Quang-VM/STM32-Based-Multisine-EIS-Platform/README.md

# STM32-Based Multisine EIS Platform for Equivalent Circuit Parameter Estimation
