Quang-VM/STM32-Based-Multisine-EIS-Platform/software_host/README.md

## Host software: 

Built with **Qt 6 / PyQt6** for realtime visualization, recording and replay of the impedance
spectra streamed by the STM32 device: Nyquist and Bode plots, live serial console, threaded serial reader,
CSV record / export / load. 

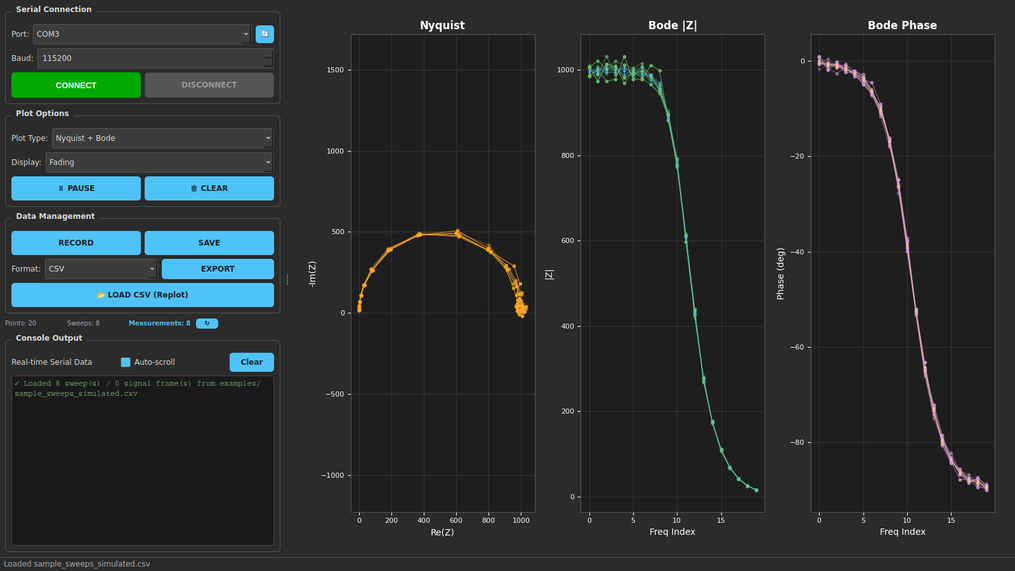
[picture p1: software_host/gui_screenshot.png]
Qt GUI
