Quang-VM/STM32-Based-Multisine-EIS-Platform/report/presentation.pdf

‹Nr.›/xx

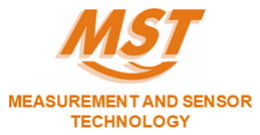
[picture p2: figure]
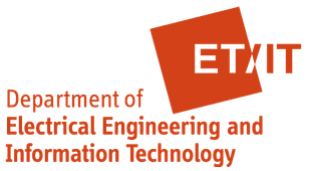
[picture p3: figure]
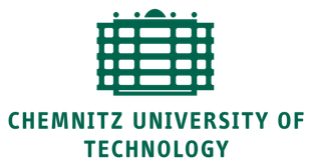
[picture p4: figure]

Group 01 <Please adapt this in the slide master>

## STM32-Based Multisine EIS Platform for Equivalent-Circuit Parameter Estimation

Tuan Minh Le
Khoi Nguyen Nguyen
Gia Khanh Nguyen
Minh Quang Vu

### „Project Lab Embedded Systems”

Chemnitz University of Technology, Chemnitz, 12th August 2026

1

Group 15 STM32-Based Multisine EIS Platform Chair of Measurement and Sensor Technology

# Overview

### Introduction

### System Architecture Overview

### Hardware and Software

### IS Measurement Results

### GUI & Dataset Pipeline

### Machine Learning Model Design

### Results and Evaluation

### Limitations & Conclusion

2

Group 15 STM32-Based Multisine EIS Platform

Member | Presentation
Gia Khanh Nguyen | Introduction System Architecture Overview Hardware and Software
Minh Quang Vu | IS Measurement Results
Khoi Nguyen Nguyen | GUI & Dataset Pipeline Machine Learning Model Design
Tuan Minh Le | Results and Evaluation Limitations & Conclusion

Chair of Measurement and Sensor Technology

# Member Responsibilities

3

Group 15 STM32-Based Multisine EIS Platform
Chair of Measurement and Sensor Technology | 4

# Introduction

THE PROBLEM
Expensive & bulky | Expert-driven fitting Interpreting a spectrum means offline curve- fitting to an equivalent circuit, supervised by a specialist.

Commercial impedance analyzers cost tens of
thousands of euros and require the DUT to be
brought into a lab.

Q1 — Measurement

How to acquire a fast, sufficiently accurate impedance spectrum using only peripherals already built into a general-purpose MCU?

Q2 — Inference

How to recover circuit topology and component values on-device, within a few tens of kB of RAM and a few ms of runtime?

2

"EIS: characterizing a material or device by measuring impedance across a frequency range"

TWO QUESTIONS TO ANSWER

# Overview of proposed Architecture

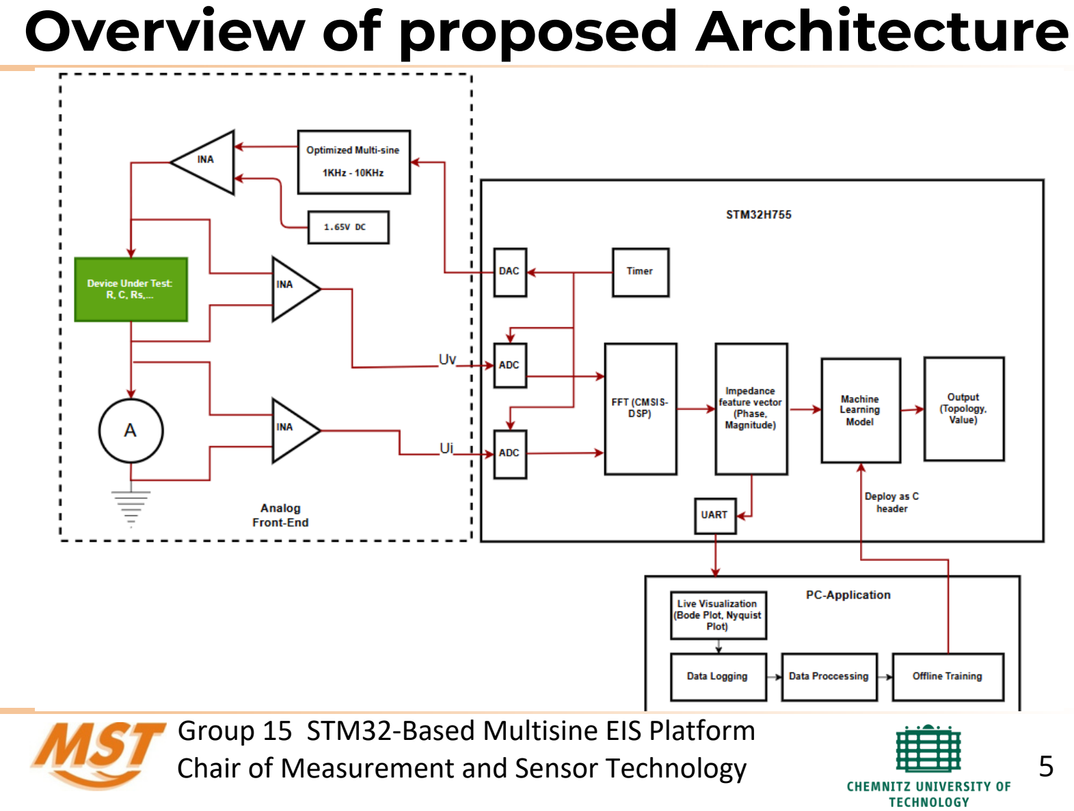
[picture p5: page 5]

Group 15 STM32-Based Multisine EIS Platform

# Hardware — Analog Front-End

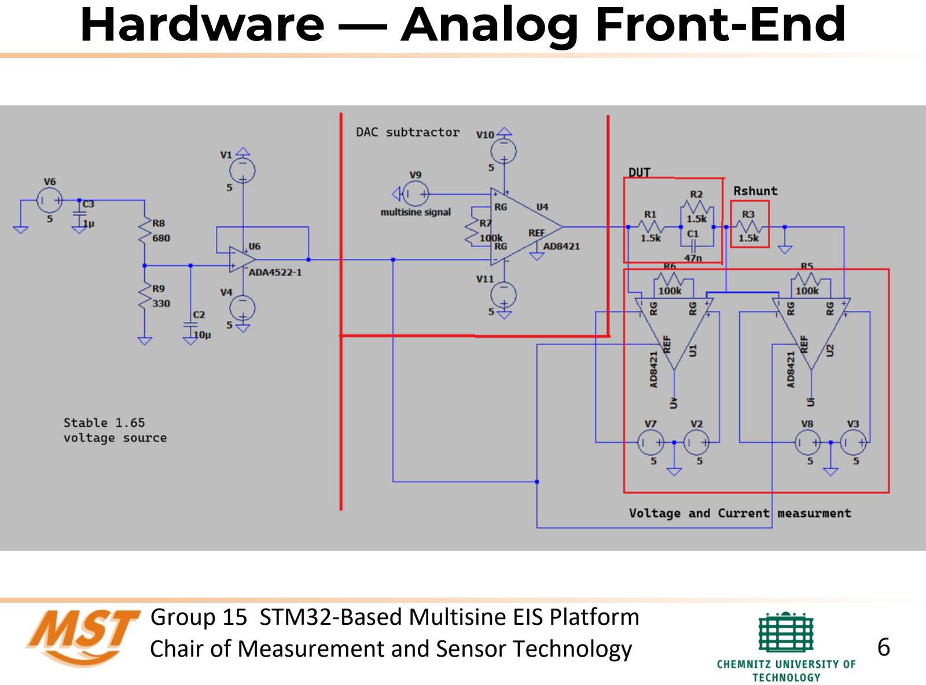
[picture p6: page 6]

Group 15 STM32-Based Multisine EIS Platform

# Firmware & DSP

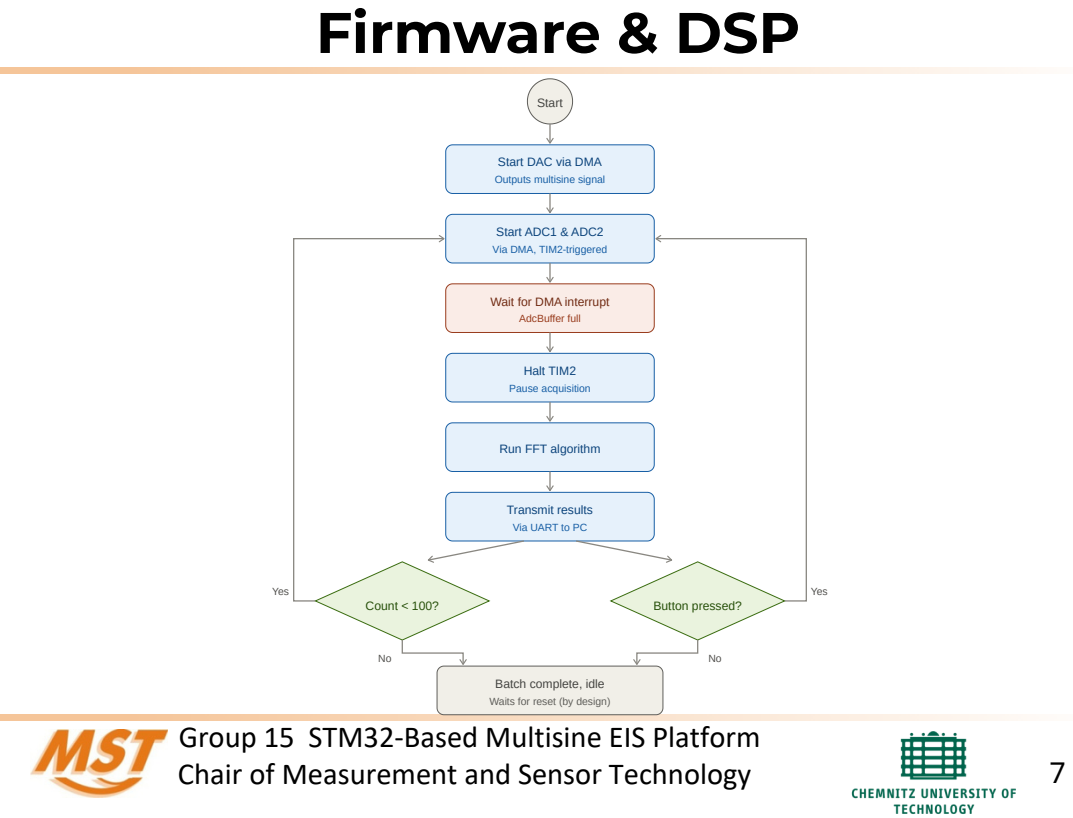
[picture p7: page 7]
Start; Halt TIM2; Pause acquisition; Count < 100?; Button pressed?; Yes

Start DAC via DMA
Outputs multisine signal

Start ADC1 & ADC2
Via DMA, TIM2-triggered

Wait for DMA interrupt
AdcBuffer full

Run FFT algorithm

Transmit results
Via UART to PC

Batch complete, idle
Waits for reset (by design)

Group 15 STM32-Based Multisine EIS Platform

# Firmware & DSP

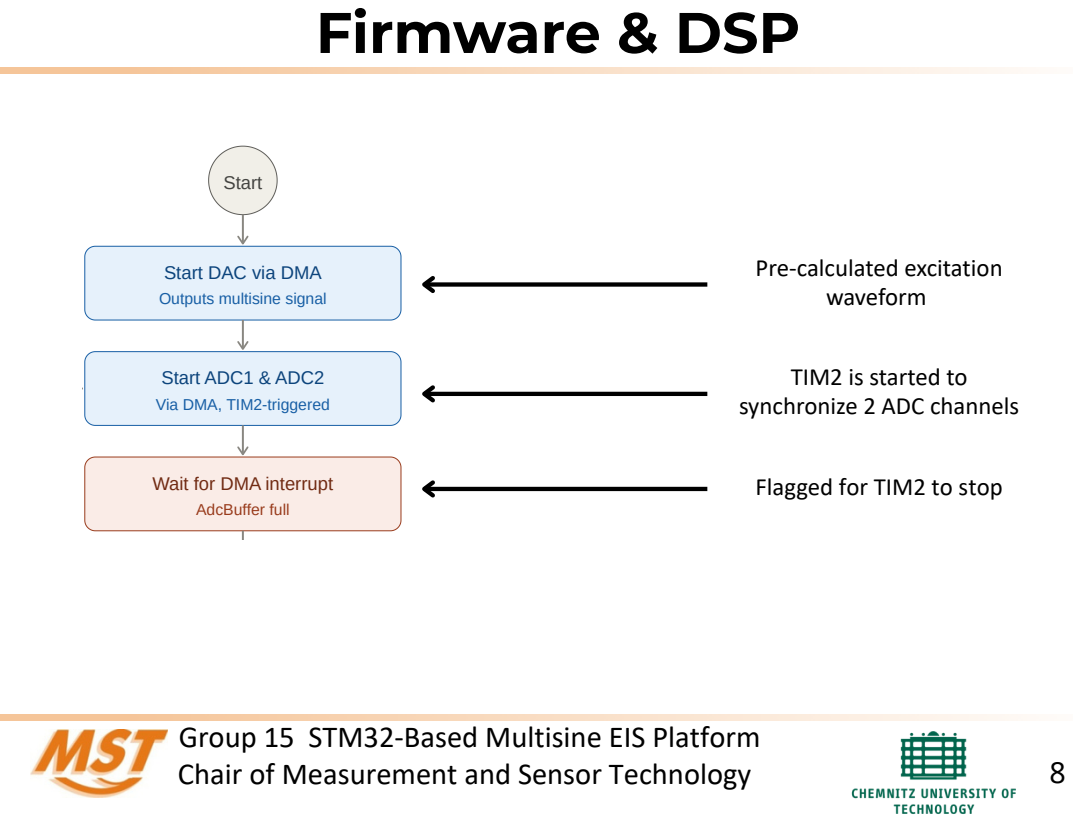
[picture p8: page 8]
Start

Pre-calculated excitation
waveform

Start DAC via DMA
Outputs multisine signal

Start ADC1 & ADC2
Via DMA, TIM2-triggered

TIM2 is started to
synchronize 2 ADC channels

Wait for DMA interrupt
AdcBuffer full

Flagged for TIM2 to stop

Group 15 STM32-Based Multisine EIS Platform

# Firmware & DSP

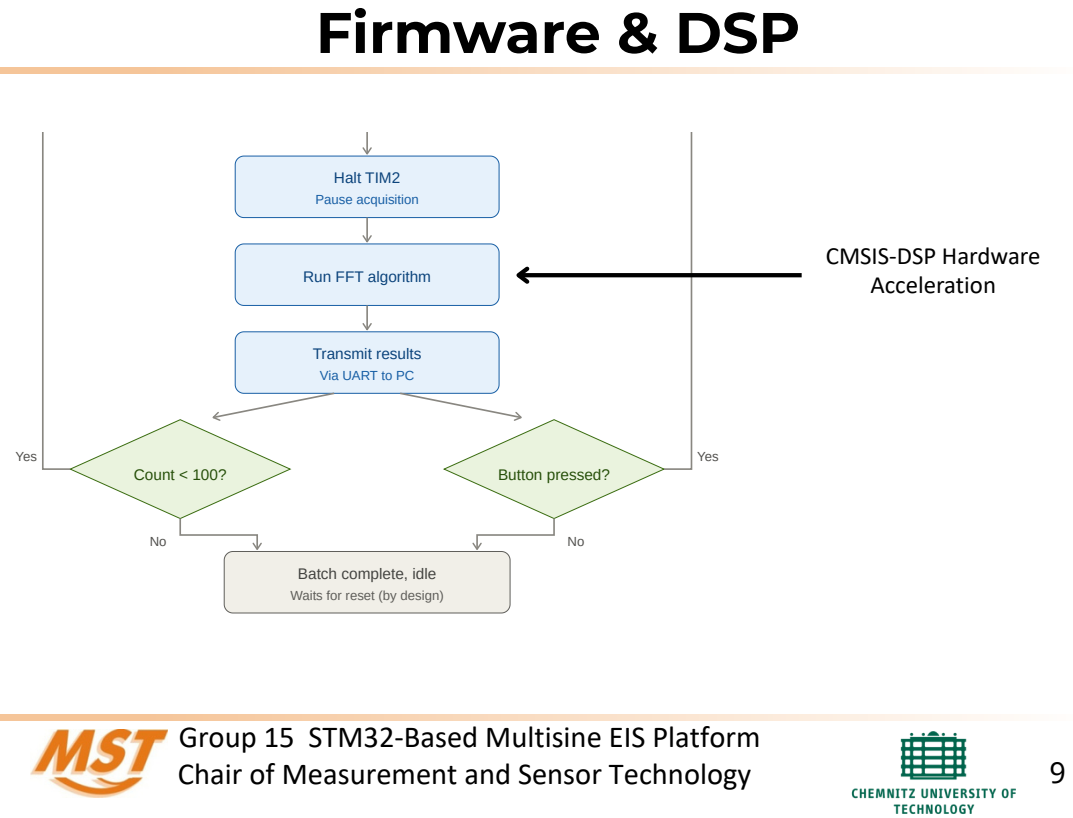
[picture p9: page 9]
Halt TIM2; Pause acquisition; Count < 100?; Button pressed?; Yes

CMSIS-DSP Hardware
Acceleration

Run FFT algorithm

Transmit results
Via UART to PC

Batch complete, idle
Waits for reset (by design)

Group 15 STM32-Based Multisine EIS Platform

Group 15 STM32-Based Multisine EIS Platform

# IS Measurement Results

“Relative Complex Error (RCE) at Anchor Frequencies for Representative Components”

Test Setup
- 4 topologies: R, C, Series RC, Parallel RC
- Grid: 6 R-values × 5–6 C-values
- 60–85 repeated measurements per combination

Evaluation Metric — Relative Complex Error (RCE)
- Compares measured complex impedance vs. theoretical value
- Reference computed from nominal (labeled) R, C values
- Evaluated across 1–10 kHz excitation band

# IS Measurement Results

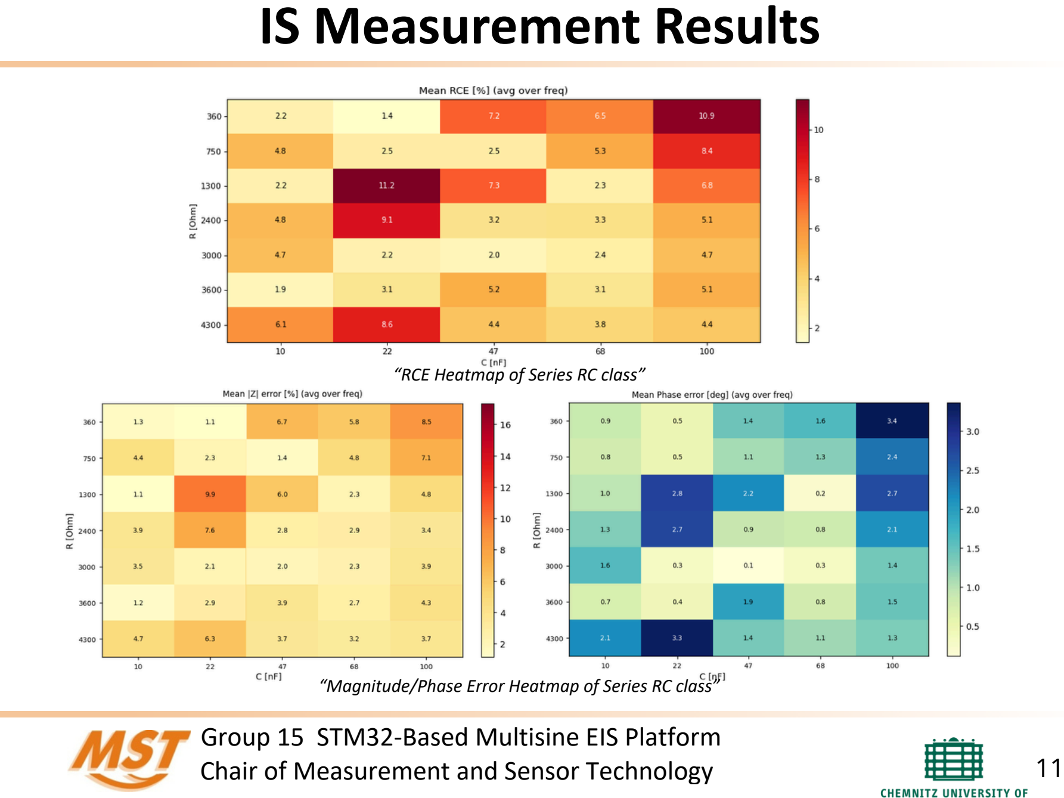
[picture p10: page 11]

Group 15 STM32-Based Multisine EIS Platform

“RCE Heatmap of Series RC class”

“Magnitude/Phase Error Heatmap of Series RC class”

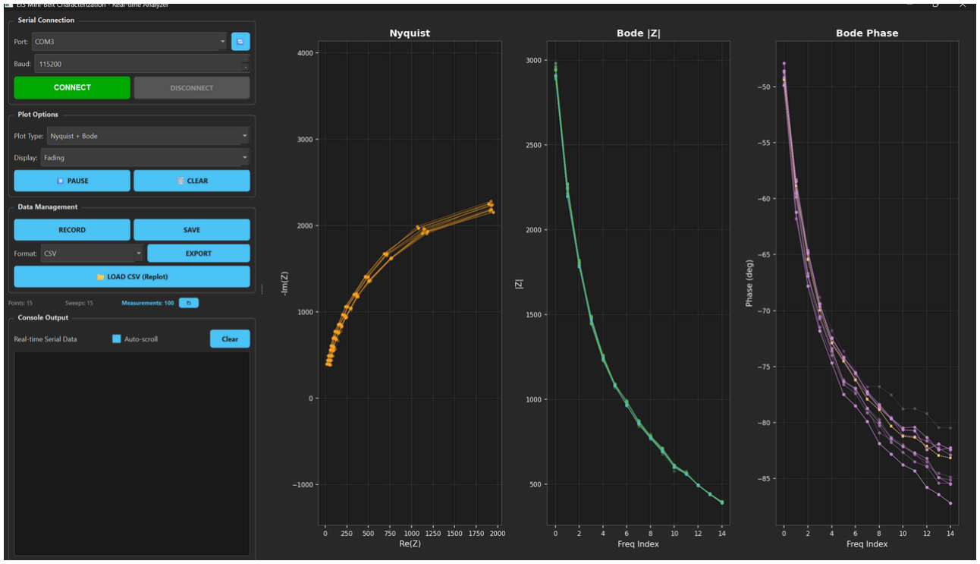
[picture p11: figure]

Group 15 STM32-Based Multisine EIS Platform

# GUI

Receives & plots UART data in real time (Nyquist, Bode |Z|, Bode phase) Labels data (Label, R, C) + exports CSV → the source of the training data Its real role: a quality-control gate before entering the ML pipeline

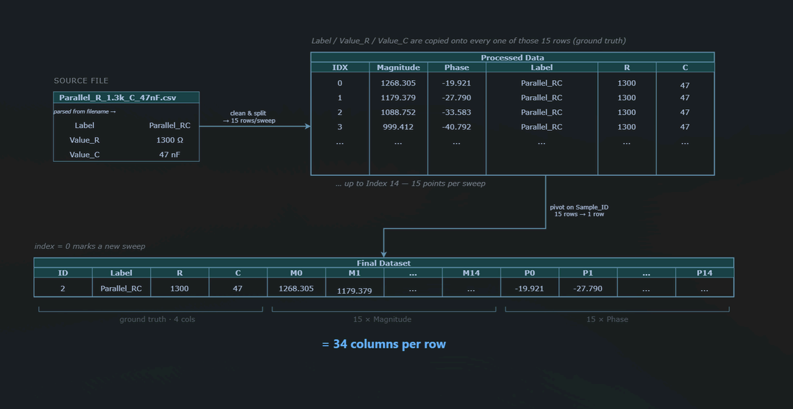
[picture p12: figure]

Group 15 STM32-Based Multisine EIS Platform

# Dataset Pipeline

# Dataset Pipeline

## Result :

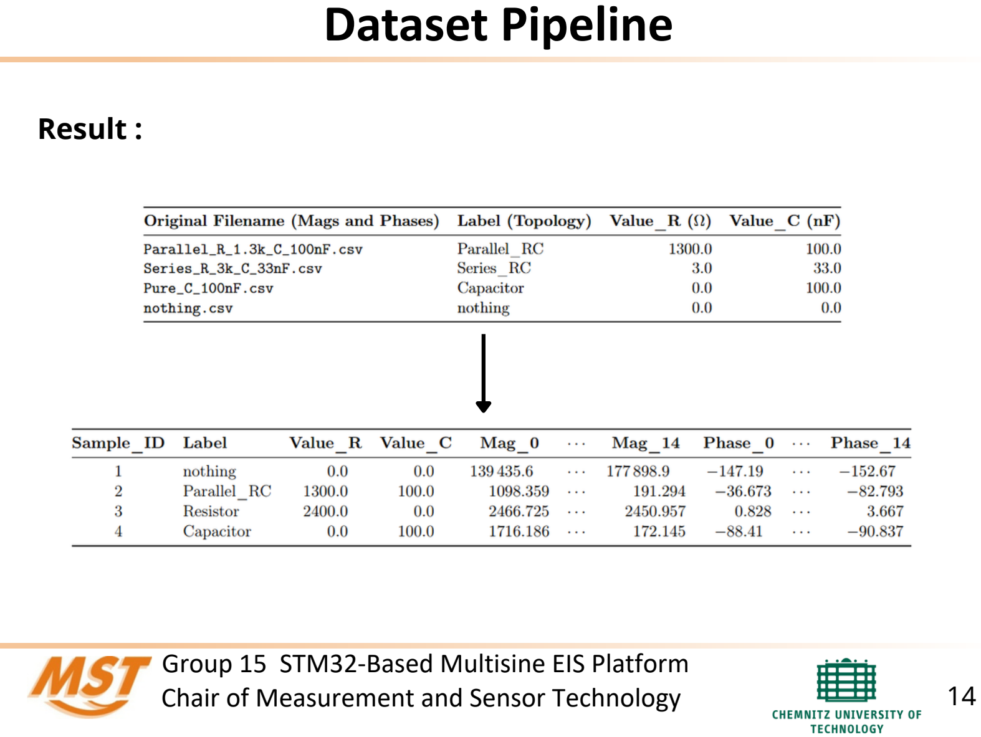
[picture p13: page 14]

Group 15 STM32-Based Multisine EIS Platform

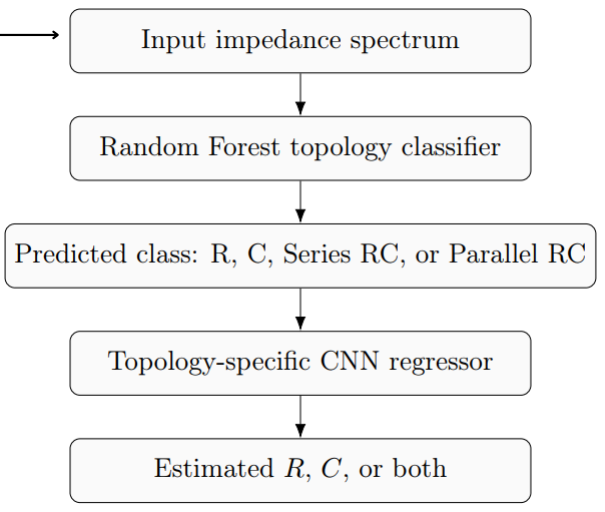
[picture p14: figure]

Group 15 STM32-Based Multisine EIS Platform

# Machine Learning Model Design

## Stage 1: Classification

## Stage 2: Regression

Cleaned Dataset

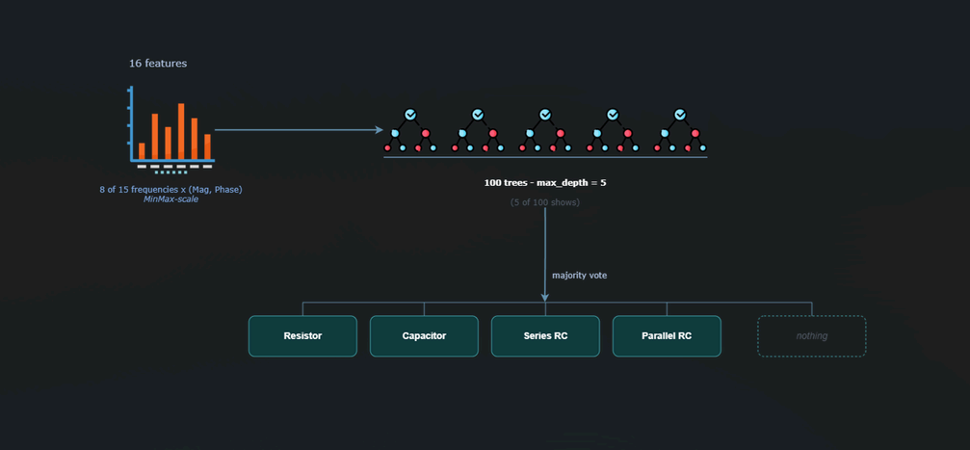
[picture p15: figure]

Group 15 STM32-Based Multisine EIS Platform

# Machine Learning Model Design

## Stage 1: Classification

Input: 16 features (magnitude + phase at 8 of 15 frequencies), MinMax-scaled Config: 100 trees, max_depth = 5
Benkmark it with Decision Tree, SVM-RBF, MLP

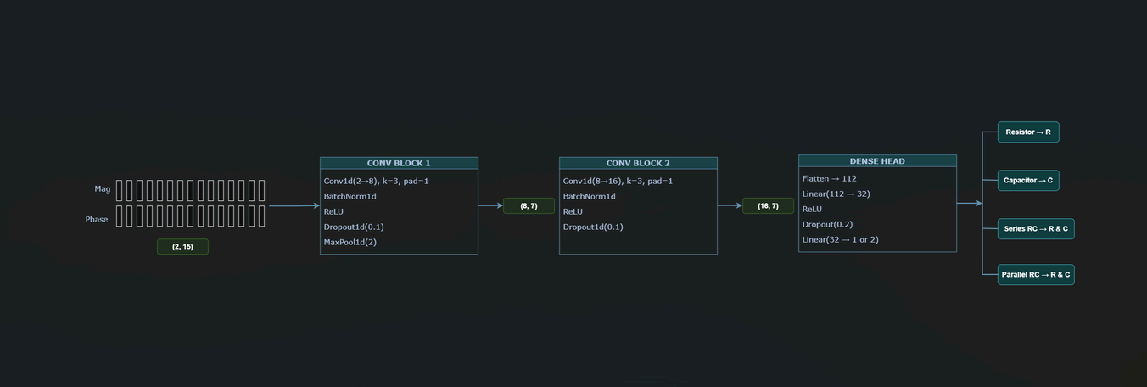
[picture p16: figure]

Group 15 STM32-Based Multisine EIS Platform

# Machine Learning Model Design

## Stage 2: Regression

Input: 2×15 tensor - a Magnitude channel and a Phase channel over frequency 4 independent instances - trained separately per topology
Split: GroupShuffleSplit (80/20) - scalers fit only on the training set
Optimizer AdamW · Huber loss (robust to outliers) · LR scheduler · Early stopping

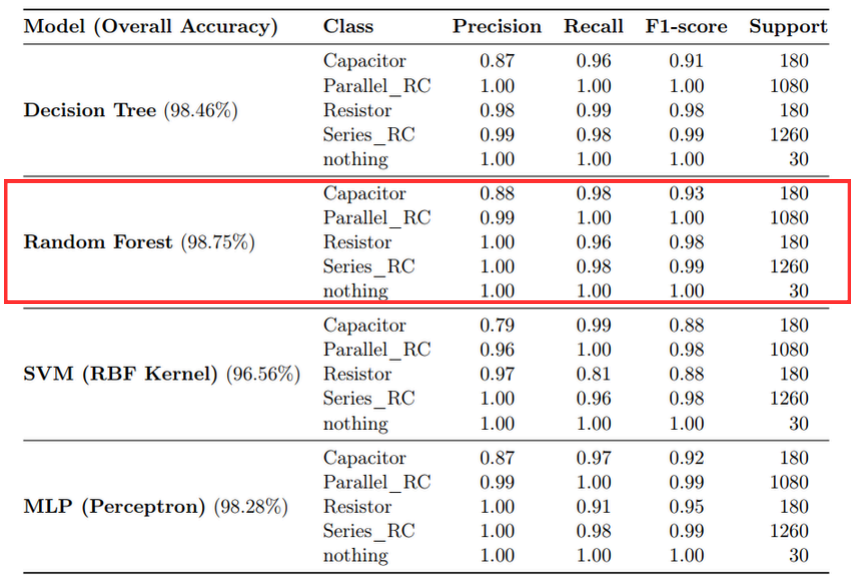
[picture p17: figure]

Group 15 STM32-Based Multisine EIS Platform

# Results and Evaluation

## Classification

## Regression

# Results and Evaluation

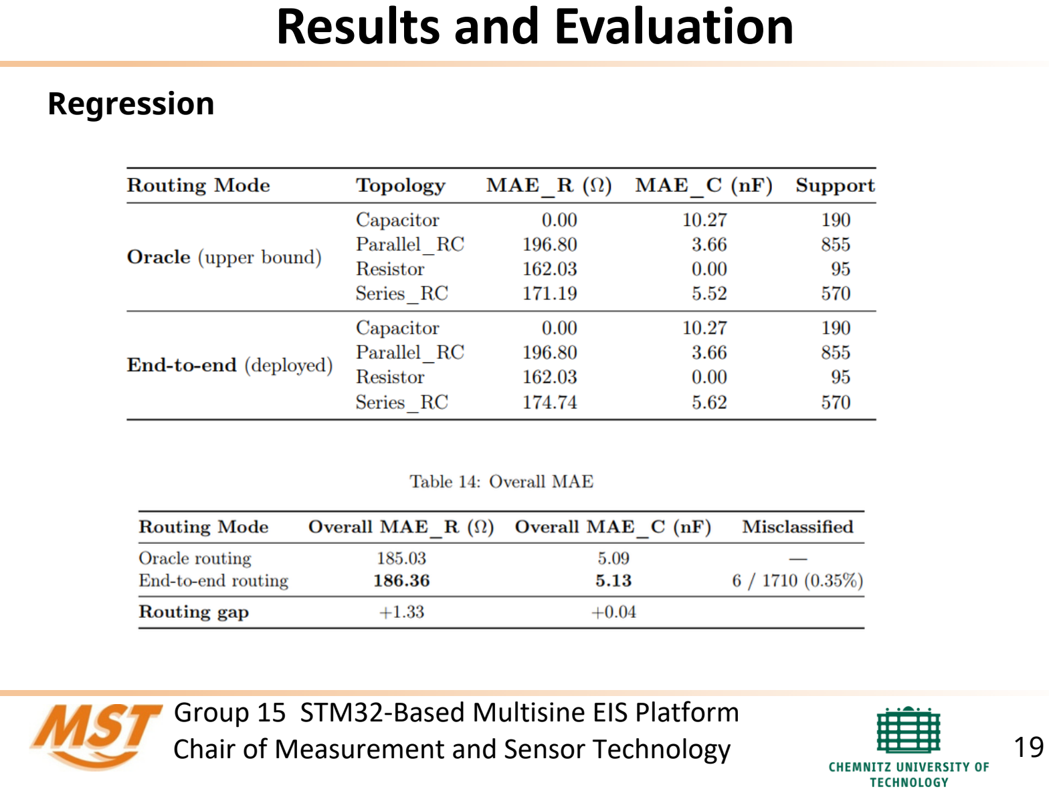
[picture p18: page 19]

Group 15 STM32-Based Multisine EIS Platform

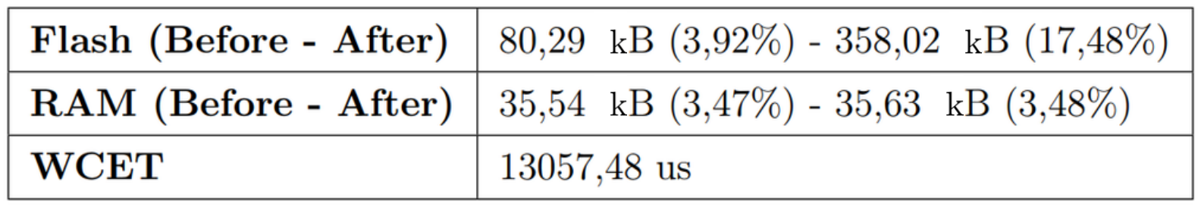
[picture p19: figure]

Group 15 STM32-Based Multisine EIS Platform

## Deployment

# Results and Evaluation

=> The machine learning model needs: 13,56 % of total Flash
0,01 % of total RAM
about 13 ms of runtime per iteration

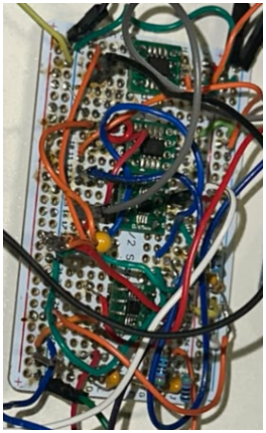
[picture p20: figure]

Group 15 STM32-Based Multisine EIS Platform

## Self-soldered wiring

=> messy circuit,
unwanted noise,

## hard for rewiring

# Limitations

## Use manufacturer’s values as baseline

## => not very accurate for circuit and ML model analysis

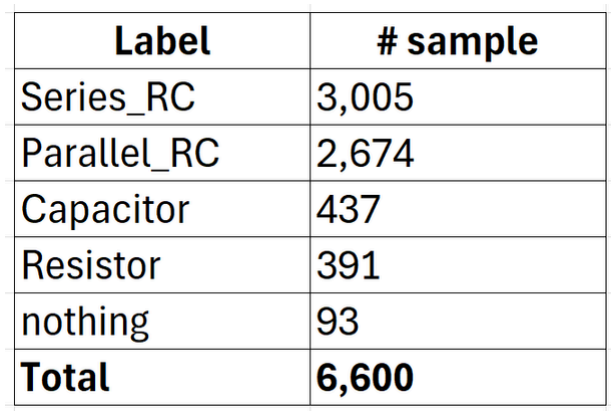
[picture p21: figure]

Group 15 STM32-Based Multisine EIS Platform

## Imbalanced dataset

## => varying reliability between classes

# Limitations

## Data splitting strategy

### => random split in classification stage allow similar impedance patterns in both training and validation ⟶ Memorizing but not generalizing

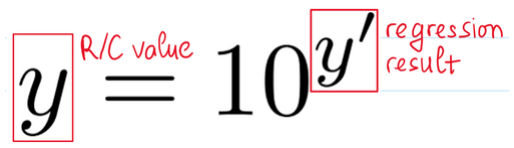
[picture p22: figure]

Group 15 STM32-Based Multisine EIS Platform

## Error propagation

## => wrong classification surely leads to wrong regression

# Limitations

## Limited number of circuit configurations

## => still cannot work with other more complex circuits

## Logarithmic error scaling

## => small deviation in regression results can lead to large deviation in R/C values

Group 15 STM32-Based Multisine EIS Platform

System is usable, accurate, fast and resource-efficient.

# Conclusions

## Some possibilities for improvements: Design a dedicated board for the system (PCB) Apply more advanced calibration techniques Train the ML model with more complex configurations Collect more data for training

25

# Thank you for attention

Q&A
