Quang-VM/STM32-Based-Multisine-EIS-Platform/ML/machine_learning/validation_predictions_cascade.xlsx

Sheet: Classifier
Accuracy | n_val
0.9918128655 | 2565
 | Capacitor | Parallel_RC | Resistor | Series_RC
Capacitor | 170 | 0 | 0 | 1
Parallel_RC | 0 | 1026 | 0 | 0
Resistor | 0 | 4 | 167 | 0
Series_RC | 15 | 1 | 0 | 1181

Sheet: Oracle_by_Label
Label | n_samples | MAE_R | MAE_C
Capacitor | 190 | 0 | 10.26776873
Parallel_RC | 855 | 196.8029734 | 3.658590331
Resistor | 95 | 162.0320904 | 0
Series_RC | 570 | 171.1915148 | 5.518186087

Sheet: Oracle_by_Group
Group_ID | n_samples | MAE_R | MAE_C
Capacitor_0.0_10.0 | 95 | 0 | 5.346867973
Capacitor_0.0_47.0 | 95 | 0 | 15.18866949
Parallel_RC_1300.0_47.0 | 95 | 25.27206003 | 8.427578133
Parallel_RC_2400.0_10.0 | 95 | 119.780091 | 2.535343451
Parallel_RC_3000.0_10.0 | 95 | 94.69461863 | 1.757810944
Parallel_RC_3000.0_47.0 | 95 | 63.37870837 | 1.030942937
Parallel_RC_3600.0_22.0 | 95 | 299.6222065 | 2.893756304
Parallel_RC_3600.0_47.0 | 95 | 221.5937526 | 2.026062574
Parallel_RC_4300.0_68.0 | 95 | 834.2697959 | 2.157541054
Parallel_RC_750.0_33.0 | 95 | 56.28472194 | 4.918307917
Parallel_RC_750.0_47.0 | 95 | 56.33080605 | 7.179969667
Resistor_3000.0_0.0 | 95 | 162.0320904 | 0
Series_RC_2400.0_100.0 | 95 | 46.97303403 | 22.37403492
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
