Quang-VM/STM32-Based-Multisine-EIS-Platform/hardware/LTSPICE/Draft1.asc

C1: cap; 47n
C2: cap; 10µ
C3: cap; 1µ
R1: res; 1.5k
R2: res; 1.5k
R3: res; 1.5k
R5: res; 100k
R6: res; 100k
R7: res; 100k
R8: res; 680
R9: res; 330
U1: AD8421
U2: AD8421
U4: AD8421
U6: ADA4522-1
V1: voltage; 5
V2: voltage; 15
V3: voltage; 15
V4: voltage; 5
V6: voltage; 5
V7: voltage; 15
V8: voltage; 15
V9: voltage; multisine signal
V10: voltage; 5
V11: voltage; 5
Named nets: 0, Uv, Ui
.tran 0 2.048m 0 5n
