Quang-VM/STM32-Based-Multisine-EIS-Platform/(commit log)

2026-09-27 upload slide/report _ stm32 code
2026-09-28 update RM
    [Parallel_R_1.3k_C_100nF.csv, Parallel_R_1.3k_C_100nF_processed.csv, Parallel_R_1.3k_C_10nF.csv, Parallel_R_1.3k_C_10nF_processed.csv, Parallel_R_1.3k_C_22nF.csv, Parallel_R_1.3k_C_22nF_processed.csv, Parallel_R_1.3k_C_33nF.csv, Parallel_R_1.3k_C_33nF_processed.csv]
